esrdevsw/Pressure-Cycling-System/PCS-control/LaNi5-ensaios/PID 50ºC.JPG

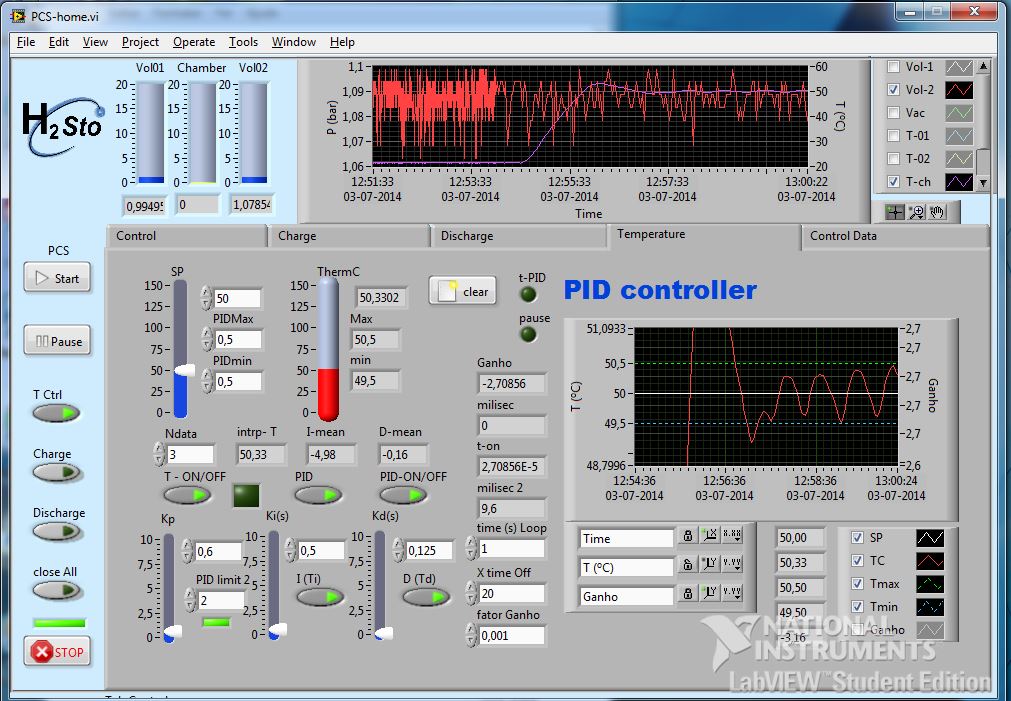
PCS-control/LaNi5-ensaios/PID 50ºC.JPG
