esrdevsw/Pressure-Cycling-System/ANM2015 - SCC_poster.pdf

The developed equipment is a volumetric system mounted with purchased elements from Swagelok Ltd, Keller Ltd. pressure transducer, and electrovalves from ASCO Numatics Ltd. The sample chamber is equipped with heating and cooling devices with temperature control in the range from 10ºC to 230ºC. The test material (LaNi5

, 99.9%) was
purchased from Alfa Aesar.

# Pressure cycling system

UNIÃO EUROPEIA

Fundo Europeu
de Desenvolvimento Regional

# Automatic equipment for hydrogen charge-discharge cycling and study of degradation and lifetime of hydrides

## E. S. Ribeiro

1

## , F. J. A. Cardoso

## 2 and J. M. Gil

1
,*

1 CFisUC, Department of Physics, University of Coimbra, P-3004-516 Coimbra, Portugal 2 GAII, Department of Physics, University of Coimbra, P-3004-516 Coimbra, Portugal *jmgil@fis.uc.pt

The hydrogen capacity loss as function of the number of pressure cycles for LaNi5

a) Partial view of the pressure vs. time cycling of LaNi5;
b) One hour hydriding/dehydriding cycle.

Define Set Pmax

After sample activation

Open/close
Valve 01

Read P

P >= Set Pmax

Open Valve 02
To charge

Read P

Calc. B (t , P)

B < 0.7

P < Set Pmax

B > =0.7

i < 50

sample charge

Close Valve 02

Open Valve 03
To discharge

Read P

Open Valve 05
To clear sample

Close all Valves

sample discharge

New cycle

The characterization of the hydrogen absorption of new materials for hydrogen storage is typically performed with high accuracy Sieverts-type volumetric devices.
Studying the aging of hydrides requires taking a sample through many hydriding cycles [1], making conventional equipment inefficient for this task [2]. Here we present a dedicated device for the cycling over a significant number of cycles.

# Introduction

The study and characterization of new materials for use in hydrogen storage includes knowing their performance, stability, aging and/or degradation resulting from charge-discharge cycles. With this objective in mind, our group has developed an automated device whose purpose is to repeatedly undergo hydrogen charging and discharging in order to assess the longevity of the hydride. The equipment was tested with the LaNi5

-H system, where a significant degradation is observed over 1500 cycles.

This work was partially supported by the Program COMPETE: PEst-C/FIS/UI0036/2011 strategic project and FCT through project PTDC/EME-MFE/103051/2008. E.S.R. wishes to acknowledge the Portuguese funding institution FCT - Fundação para a Ciência e Tecnologia for the Ph.D. Grant SFRH/BD/78733/2011.

# Acknowledgements

# Results

6

th International conference on Advanced Nanomaterials, 1

st International conference on Graphene Technology
1

st International conference on Hydrogen Energy.

Aveiro, Portugal, July 20-22 2015

[1] Lambert, S.W., et al. J. Alloys Compd, 187, 113 (1992).
[2] G. Meyer, et. al. Rev. Sci. Instrum. 78, 023903 (2007).

# References

The testing equipment was successfully implemented, where we observe a loss of approximately 20% of the absolute capacity for LaNi5

-H system with 1500 cycles. For the study of new materials, we can use this equipment to simulate real situations of hydrogen storage tanks.

# Conclusion

A dedicated control and
communication | board | was
developed for the automation
of | this | equipment. | The
experiment | is | controlled
through a code developed in LabView with a graphical
interface, including a PID
code | for | thermal | control
allowing | the | study | at
different temperatures.
cycle | -DH | -DS
nº. | [kJ/mol H2 ] | [J/(mol H2 K)]
500 | 32.0 | 115
1000 | 31.4 | 113
1500 | 32.0 | 115

ln ( )

S | H P
R | RT
D | D
= - | +

van‘t Hoff plot from a series of PCT measurements for LaNi5

Heating
face

cooling
face

(a)

(b)

The shape of the absorption/desorption isotherm curves is also relevant to the degradation of hydriding properties of an intermetallic compound.
