esrdevsw/Pressure-Cycling-System/(list of files, drawings)

Other design files:
PCS-control/LaNi5-ensaios/Isotermicas_PCS_LaNi5.opj
PCS-control/LaNi5-ensaios/Volume_chamber_LaNi5.opj
