esrdevsw/Pressure-Cycling-System/arduino_prototype/SCC.ino

#include <Arduino.h>

/*
  Controle manual e automatico do SCC.
 */
#include <SD.h>

/* On the Ethernet Shield, CS is pin 4. Note that even if it's not
 // used as the CS pin, the hardware CS pin (10 on most Arduino boards,
 // 53 on the Mega) must be left as an output or the SD library
 functions will not work.
 */
const int chipSelect = 53;

boolean led=26;      // led no pino 26
//boolean botao=28;  // botÃ£o no pino 28
int var=0;       // valor instantaneo enviado pelo botÃ£o
int var2=0;     // valor guardado
int estado=0;  // guarda o valor 0 ou 1 (HIGH ou LOW)

// relay
boolean rly01=4;  // relay val 01 - gas
boolean rly02=6;  // relay val 02 - vol A -> camara
boolean rly03=8;  // relay val 03 - camara -> vol B
boolean rly04=2;  // relay val 04 - ATM
boolean rly05=12;  // relay val 05 - vacuo

boolean botaostart=32; // botao iniciar
// relay manual
boolean val01=30; // botao val01
boolean val02=28; // botao val02
boolean val03=26; // botao val03
boolean val04=24; // botao val04
boolean val05=22; // botao val05

boolean ledverde=25;      // led verde
boolean ledvermelho=23;      // led vermelho.

boolean vacuo=38; // botao
boolean atm=40; // botao

boolean Pmais=34; // botao
boolean Pmenos=36; // botao

//boolean btrly01=24; // botao relay
//boolean btrly03=22; // botao relay
// temperatura

uint8_t pontoA = 13;
uint8_t pontoB = 10;
float valorA = 0;
float valorB = 0;
float diferenca = 0;
uint8_t pontoA2 = 11;
uint8_t pontoB2 = 12;
float valorA2 = 0;
float valorB2 = 0;
float diferenca2 = 0;
uint8_t pontoA3 = 9;
uint8_t pontoB3 = 14;
float valorA3 = 0;
float valorB3 = 0;
float diferenca3 = 0;
float R6 = 100;
float R7 = 5000;
float Res01 = 0;
float Res02 = 0;
float Res03 = 0;
float K2 = -2.4202e+02;
float K3 = 2.2228e+00;
float K4 = 2.5859e-03;
float K5 = -4.8260e-06;
float K6 = -2.8183e-08;
float K7 = 1.5243e-10;
float temperatura = 0;
float temperatura2 = 0;
float temperatura3 = 0;

// pressao
float  volA = 0;
float  volB = 0;
float PvolA = 0;
float PvolB = 0;
float pressao = 0;

//////////////////////////////////////////////////////////////////////////
float defPV01 = 0; // set de pressao
float readPV01 = 0;    // leitura pressao volume 01
float TempA = 0; // temperatura volume 01
float TempC = 0; // temperatura da camara
float readPV02 = 0; // leitura pressao volume 02
float TempB = 0; // temperatura volume 02

int ciclos = 1;
int estagio =0;
int Tciclos =10;
float tempo = 500; // tempo para leitura da pressao milisegundos

float average = 0;
float total = 0;                            // total móvel
float readings[5];                // qtde de amostras
int index = 0;                            // índice da leitura atual

float tempoC = 0;
float averageT = 0;
float totalT = 0;                            // total móvel
float readingsT[5];

float taxaT1=0;
float taxaT2=0;

float taxaP1=0;
float taxaP2=0;

float Dt = 0;
float DP = 0;

float DPDT = 1;

float tempoCin = 0;

void setup()
{
  // initialize the digital pin as an output.
  Serial.begin(9600);

  pinMode(ledverde,OUTPUT);
  pinMode(ledvermelho,OUTPUT);

  pinMode(botaostart,INPUT);

  pinMode(rly01,OUTPUT);
  pinMode(rly02,OUTPUT);
  pinMode(rly03,OUTPUT);
  pinMode(rly04,OUTPUT);
  pinMode(rly05,OUTPUT);


  pinMode (val01,INPUT);
  pinMode (val02,INPUT);
  pinMode (val03,INPUT);
  pinMode (val04,INPUT);
  pinMode (val05,INPUT);

  pinMode (vacuo,INPUT);
  pinMode (atm,INPUT);

  pinMode (volA,INPUT);
  pinMode (volB,INPUT);


  Serial.print("Initializing SD card...");
  // make sure that the default chip select pin is set to
  // output, even if you don't use it:
  pinMode(53, OUTPUT);

  // see if the card is present and can be initialized:
  if (!SD.begin(chipSelect))
  {
    Serial.println("Card failed, or not present");
    // don't do anything more:
    return;
  }
  Serial.println("card initialized.");

  File dataFileCin = SD.open("cinetica.txt", FILE_WRITE);
  dataFileCin.print("ciclos");
  dataFileCin.print(" |   ");
  dataFileCin.print("tempo (s)");
  dataFileCin.print("   ");
  dataFileCin.print("PV01 () ");
  dataFileCin.print("   ");
  dataFileCin.print("T A ()");
  dataFileCin.print("   ");
  dataFileCin.print("T C ()");
  dataFileCin.print("   ");
  dataFileCin.print("PV02 () ");
  dataFileCin.print("   ");
  dataFileCin.println("T B ()");
  dataFileCin.close();

  File dataFile = SD.open("datalog.txt", FILE_WRITE);
  dataFile.println(" planilha de calculo SCC");
  dataFile.close();


}

void SDcardCalc()
{

  File dataFile = SD.open("datalog.txt", FILE_WRITE);
  // if the file is available, write to it:
  if (dataFile)
  {
    dataFile.println(" planilha de calculo SCC");
    dataFile.close();
  }
  // if the file isn't open, pop up an error:
  else {
    Serial.println("error opening datalog.txt");
    //    Serial.println(dataString);
  }
}
void PCrtA ()
{
  digitalWrite(rly01, HIGH);
  delay(7);
  digitalWrite(rly01, LOW);
  delay(tempo);
}
void carga ()
{
  digitalWrite(rly02, HIGH);
  delay(7);
  digitalWrite(rly02, LOW);
  delay(tempo);
}

void descarga ()
{
  digitalWrite(rly03, HIGH);
  delay(7);
  digitalWrite(rly03, LOW);
  delay(tempo);
}

void vacuosis ()
{
  for (int j = 0; j < 5; j++)
  {
    Serial.println(j);

    digitalWrite(ledverde, LOW);
    delay(10);
    digitalWrite(ledvermelho, HIGH);

    digitalWrite(rly05, HIGH);
    delay(2000);
    digitalWrite(rly03, HIGH);
    delay(2000);
    digitalWrite(rly02, HIGH);
    delay(2000);
    //      digitalWrite(rly01, HIGH);
    //      delay(2000);

    delay(6000);

    //      digitalWrite(rly01, LOW);
    //      delay(10);
    digitalWrite(rly02, LOW);
    delay(1000);
    digitalWrite(rly03, LOW);
    delay(1000);
    digitalWrite(rly05, LOW);
    delay(1000);

    digitalWrite(ledvermelho, LOW);
    digitalWrite(ledverde, HIGH);
    delay(1000);
  }
}

void atmsis ()
{
  for (int j = 0; j < 1; j++)
  {
    digitalWrite(ledverde, LOW);
    delay(10);
    digitalWrite(ledvermelho, HIGH);

    digitalWrite(rly04, HIGH);
    delay(1000);
    digitalWrite(rly03, HIGH);
    delay(1000);
    digitalWrite(rly02, HIGH);
    delay(1000);
    //      digitalWrite(rly01, HIGH);
    //      delay(2000);

    delay(1000);

    //      digitalWrite(rly01, LOW);
    //      delay(10);
    digitalWrite(rly02, LOW);
    delay(1000);
    digitalWrite(rly03, LOW);
    delay(1000);
    digitalWrite(rly04, LOW);
    delay(1000);


    digitalWrite(ledvermelho, LOW);
    digitalWrite(ledverde, HIGH);
    delay(1000);
  }
}

void tempsis()
{
  // temperatura
  valorA = analogRead(pontoA);
  valorB = analogRead(pontoB);
  diferenca = valorA - valorB;
  valorA2 = analogRead(pontoA2);
  valorB2 = analogRead(pontoB2);
  diferenca2 = valorA2 - valorB2;
  valorA3 = analogRead(pontoA3);
  valorB3 = analogRead(pontoB3);
  diferenca3 = valorA3 - valorB3;
  diferenca = (diferenca*5000)/1023;
  diferenca2 = (diferenca2*5000)/1023;
  diferenca3 = (diferenca3*5000)/1023;
  Res01 = (((R6*R7)-(((R6*R7)/(R6+R6))-diferenca)*R6)/(((R6*R7)/(R6+R6))-diferenca))-2.37;
  Res02 = (((R6*R7)-(((R6*R7)/(R6+R6))-diferenca2)*R6)/(((R6*R7)/(R6+R6))-diferenca2))-2.37;
  Res03 = (((R6*R7)-(((R6*R7)/(R6+R6))-diferenca3)*R6)/(((R6*R7)/(R6+R6))-diferenca3))-2.37;
  temperatura = K2+K3*Res01+K4*pow(Res01,2)+K5*pow(Res01,3)+K6*pow(Res01,4)+K7*pow(Res01,5);
  temperatura2 = K2+K3*Res02+K4*pow(Res02,2)+K5*pow(Res02,3)+K6*pow(Res02,4)+K7*pow(Res02,5);
  temperatura3 = K2+K3*Res03+K4*pow(Res03,2)+K5*pow(Res03,3)+K6*pow(Res03,4)+K7*pow(Res03,5);
}

void Psis()
{
  volA = (analogRead(A3)-60);
  volB = (analogRead(A4)-60);

  // conversao de bits para pressao em milibar

  PvolA = map(volA, -59, 832, 1000, 21207);
  PvolB = map(volB, -59, 832, 1000, 21207);
}

void setpressao()
{
  if (digitalRead(Pmais)==HIGH)
  {

    defPV01=defPV01+0.01;

    Serial.print("definindo set de  ");
    Serial.print(defPV01);
    Serial.println( " bar para volume A ");

  }
  if (digitalRead(Pmenos)==HIGH)
  {

    defPV01=defPV01-0.01;

    Serial.print("definindo set de  ");
    Serial.print(defPV01);
    Serial.println( " bar para volume A ");


  }
}

void printela()
{
            Serial.print(ciclos);
            Serial.print("  ");
            Serial.print(tempoC);
            Serial.print("  ");
            Serial.print(defPV01);
            Serial.print("  ");
            Serial.print(PvolA/1000);
            Serial.print("  ");
            Serial.print(temperatura2);
            Serial.print("  ");
            Serial.print(PvolB/1000);
            Serial.print("  ");
            Serial.print("|");
            Serial.print("  ");
            Serial.print(index);
            Serial.print("  ");
            Serial.print(Dt);
            Serial.print("  ");
            Serial.print(DP);
            Serial.print("  ");
            Serial.println(DPDT);
}
void SDcardCin()
{
  Psis();
  tempsis();
  // open the file. note that only one file can be open at a time,
  // so you have to close this one before opening another.
  File dataFileCin = SD.open("cinetica.txt", FILE_WRITE);
  // if the file is available, write to it:
  if (dataFileCin)
  {
    tempoCin=tempoCin+0.507;

    dataFileCin.print(ciclos);
    dataFileCin.print("  ");
    dataFileCin.print(tempoC);
    dataFileCin.print("  ");
    dataFileCin.print(defPV01);
    dataFileCin.print("  ");
    dataFileCin.print(PvolA/1000);
    dataFileCin.print("  ");
    dataFileCin.print(temperatura2);
    dataFileCin.print("  ");
    dataFileCin.print(PvolB/1000);
    dataFileCin.print("   ");
    dataFileCin.print(temperatura);
    dataFileCin.print("   ");
    dataFileCin.print(temperatura3);
    dataFileCin.print("  ");
    dataFileCin.print("|");
    dataFileCin.print("  ");
    dataFileCin.print(index);
    dataFileCin.print("  ");
    dataFileCin.print(Dt);
    dataFileCin.print("  ");
    dataFileCin.print(DP);
    dataFileCin.print("  ");
    dataFileCin.println(DPDT);
    dataFileCin.close();

  }
  // if the file isn't open, pop up an error:
  else {
    Serial.println("error opening cinetica.txt");
    //    Serial.println(dataString);
  }
}
void(* resetFunc) (void) = 0; //declare reset function @ address 0

void loop()
{
  setpressao();

  var=digitalRead(botaostart); // ler o valor enviado pelo botÃ£o: "HIGH" ou "LOW"

  if ((var == HIGH) && (var2 == LOW))
  {
    estado = 1 - estado;
    delay(50);
  }

  var2=var;
  if (estado == 1) // modo automatico
  {

    while (ciclos <= Tciclos)
    {


      File dataFile = SD.open("datalog.txt", FILE_WRITE);
      dataFile.println(">>>>>>>>>>>>>>>>>>>>>>>>");
      dataFile.print("lendo o ciclo ");
      dataFile.println(ciclos);

      dataFile.println("index   tempoC  PvolA   ");
      dataFile.close();

      for (int j = 0; j < 2; j++)
      {

        index = 0;

        for (int i = 0; i < 3; i++)
        {
          Psis();
          tempsis();
          digitalWrite(ledvermelho, LOW);
          digitalWrite(ledverde, HIGH);


          if ((estagio==0))// carga do volume A
          {
            PCrtA();
            SDcardCin();

            printela();


            if ((PvolA/1000) > defPV01)
            {
              estagio=1;
              Serial.println("iniciar carga da camara");

              File dataFileCin = SD.open("cinetica.txt", FILE_WRITE);
              dataFileCin.println(">>>>>>>>>>>>>>>>>>>>>>>>");
              dataFileCin.println("iniciar carga da camara");
              dataFileCin.close();


              delay(tempo);
            }
          }

          if ((estagio==1))// carga da camara
          {
            if (DPDT == 0)
            {
              if ((PvolA/1000) < defPV01)
              {
                estagio=0;
                Serial.println("carregar novamente o volume A");

                File dataFileCin = SD.open("cinetica.txt", FILE_WRITE);
                dataFileCin.println(">>>>>>>>>>>>>>>>>>>>>>>>");
                dataFileCin.println("carregar novamente o volume A");
                dataFileCin.close();

              }
              else
              {
                estagio=2;
                Serial.println(" xxxxxxxxxxxxxxxxxxxxxxxxxxxxxxxxxxxxxx     ");
                Serial.println("Inicio da descarga");

                File dataFileCin = SD.open("cinetica.txt", FILE_WRITE);
                dataFileCin.println(">>>>>>>>>>>>>>>>>>>>>>>>");
                dataFileCin.println("Inicio da descarga");
                dataFileCin.close();

                delay(tempo);
                //                    ciclos=ciclos+1;
                //                    if  (ciclos > Tciclos)
                //                    {
                //                        Serial.println(" xxxxxxxxxxxxxxxxxxxxxxxxxxxxxxxxxxxxxx     ");
                //                        Serial.println("Inicio da descarga");
                //                    }
              }
              delay(tempo);
            }

            carga();
            SDcardCin();


            printela();


            tempoC = (tempoC + 0.507); // tempo  cinetica em segundos

            totalT -= readingsT[index];               // subtrair a última leitura
            readingsT[index] = tempoC;                // ler o tempo da cinetica
            totalT += readingsT[index];               // adicionar leitura ao total
            pressao = PvolA;

            total -= readings[index];               // subtrair a última leitura
            readings[index] = pressao; // ler do sensor
            total += readings[index];               // adicionar leitura ao total
            index = (index + 1);                    // avançar ao próximo índice

            //            Serial.print(index);
            //            Serial.print("      ");
            //            Serial.print(tempoC);
            //            Serial.print("      ");
            //            Serial.println(PvolA);

            File dataFile = SD.open("datalog.txt", FILE_WRITE);
            dataFile.print(index);
            dataFile.print("      ");
            dataFile.print(tempoC);
            dataFile.print("      ");
            dataFile.println(PvolA);
            dataFile.close();
          }

          if ((estagio==2))// descarga da camara
          {
            if (DPDT == 0)
            {
              if ((PvolB/1000) > 1.05)
              {
                estagio=0;
                ciclos=ciclos+1;
                if  (ciclos > Tciclos)
                {
                  Serial.println(" xxxxxxxxxxxxxxxxxxxxxxxxxxxxxxxxxxxxxx     ");
                  Serial.println("Inicio do novo ciclo");

                  File dataFileCin = SD.open("cinetica.txt", FILE_WRITE);
                  dataFileCin.println(">>>>>>>>>>>>>>>>>>>>>>>>");
                  dataFileCin.println("Inicio do novo ciclo");
                  dataFileCin.close();
                }
              }

              else
              {
                Serial.println("limpar volume B");

                File dataFileCin = SD.open("cinetica.txt", FILE_WRITE);
                dataFileCin.println(">>>>>>>>>>>>>>>>>>>>>>>>");
                dataFileCin.println("limpar volume B");
                dataFileCin.close();

                digitalWrite(rly04, HIGH);
                delay(1000);
                digitalWrite(rly04, LOW);
                delay(1000);
                digitalWrite(rly05, HIGH);
                delay(1000);
                digitalWrite(rly05, LOW);
                delay(1000);

              }
              delay(tempo);
            }
            descarga();
            SDcardCin();

            printela();

            tempoC = (tempoC + 0.507); // tempo  cinetica em segundos

            totalT -= readingsT[index];               // subtrair a última leitura
            readingsT[index] = tempoC;                // ler o tempo da cinetica
            totalT += readingsT[index];               // adicionar leitura ao total
            pressao = PvolB;

            total -= readings[index];               // subtrair a última leitura
            readings[index] = pressao; // ler do sensor
            total += readings[index];               // adicionar leitura ao total
            index = (index + 1);                    // avançar ao próximo índice

            //            Serial.print(index);
            //            Serial.print("      ");
            //            Serial.print(tempoC);
            //            Serial.print("      ");
            //            Serial.println(PvolB);

            File dataFile = SD.open("datalog.txt", FILE_WRITE);
            dataFile.print(index);
            dataFile.print("      ");
            dataFile.print(tempoC);
            dataFile.print("      ");
            dataFile.println(PvolB);
            dataFile.close();
          }
        }
        averageT = totalT / 3;          // calcular a média tempo
        //        Serial.println("========================");
        //        Serial.print("med. t ");
        //        Serial.print(averageT);
        //        Serial.print(" ");
        average = total / 3;          // calcular a média Pressao A
        //        Serial.print("med. P ");
        //        Serial.println(average);
        //        Serial.println("========================");

        File dataFile = SD.open("datalog.txt", FILE_WRITE);
        dataFile.println("========================");
        dataFile.print("med. t ");
        dataFile.print(averageT);
        dataFile.print(" ");
        dataFile.print("med. P ");
        dataFile.println(average);
        dataFile.println("========================");

        if (j==0)
        {
          taxaT1 = averageT;
          taxaP1 = average;
        }
        else
        {
          taxaT2 = averageT;
          taxaP2 = average;
        }

        Dt = taxaT2 - taxaT1;
        DP = taxaP2 - taxaP1;

        DPDT = (float)DP/(float)Dt;

        //        Serial.println("Dt = taxaT2 - taxaT1");
        //        Serial.print(Dt);
        //        Serial.print(" ");
        //        Serial.print(taxaT2);
        //        Serial.print(" ");
        //        Serial.println(taxaT1);
        //
        //        Serial.println("DP = taxaP2 - taxaP1");
        //        Serial.print(DP);
        //        Serial.print(" ");
        //        Serial.print(taxaP2);
        //        Serial.print(" ");
        //        Serial.println(taxaP1);
        //        Serial.println("");
        //        Serial.println(DPDT);
        //        Serial.println("========================");

        //          File dataFile = SD.open("datalog.txt", FILE_WRITE);
        dataFile.println("Dt = taxaT2 - taxaT1");
        dataFile.print(Dt);
        dataFile.print(" ");
        dataFile.print(taxaT2);
        dataFile.print(" ");
        dataFile.println(taxaT1);

        dataFile.println("DP = taxaP2 - taxaP1");
        dataFile.print(DP);
        dataFile.print(" ");
        dataFile.print(taxaP2);
        dataFile.print(" ");
        dataFile.println(taxaP1);
        dataFile.println("");
        dataFile.println(DPDT);
        dataFile.println("========================");
        dataFile.close();
      }
    }
  }

  else // modo manual
  {
    // liga o led indicando controle
    digitalWrite(ledverde, HIGH);
    // controle valvulas
    if (digitalRead(val01)==HIGH)
    {
      digitalWrite(rly01, HIGH);
    }
    if (digitalRead(val01)==LOW)
    {
      digitalWrite(rly01, LOW);
    }

    if (digitalRead(val02)==HIGH)
    {
      digitalWrite(rly02, HIGH);
    }
    if (digitalRead(val02)==LOW)
    {
      digitalWrite(rly02, LOW);
    }

    if (digitalRead(val03)==HIGH)
    {
      digitalWrite(rly03, HIGH);
    }
    if (digitalRead(val03)==LOW)
    {
      digitalWrite(rly03, LOW);
    }

    if (digitalRead(val04)==HIGH)
    {
      digitalWrite(rly04, HIGH);
    }
    if (digitalRead(val04)==LOW)
    {
      digitalWrite(rly04, LOW);
    }

    if (digitalRead(val05)==HIGH)
    {
      digitalWrite(rly05, HIGH);
    }
    if (digitalRead(val05)==LOW)
    {
      digitalWrite(rly05, LOW);
    }

    if (digitalRead(vacuo)==HIGH)
    {

      Serial.println(">>>>>>>>>>>>>>>>>>>>>>>>");
      Serial.println("abrir todas as valvulas para bomba de vacuo ");
      vacuosis();
    }

    if (digitalRead(atm)==HIGH)
    {
      Serial.println(">>>>>>>>>>>>>>>>>>>>>>>>");
      Serial.println("abrir todas as valvulas para atmosfera ");
      atmsis();

    }

  }
}
